gunz0blazin/esp-soil/docs/images/pcb-bottom.png

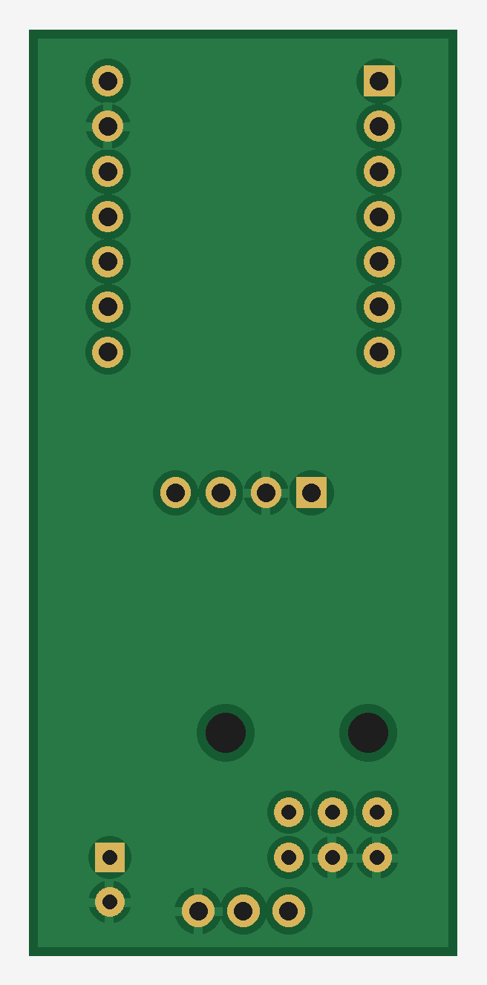
docs/images/pcb-bottom.png
