gunz0blazin/esp-soil/docs/images/pcb-top.png

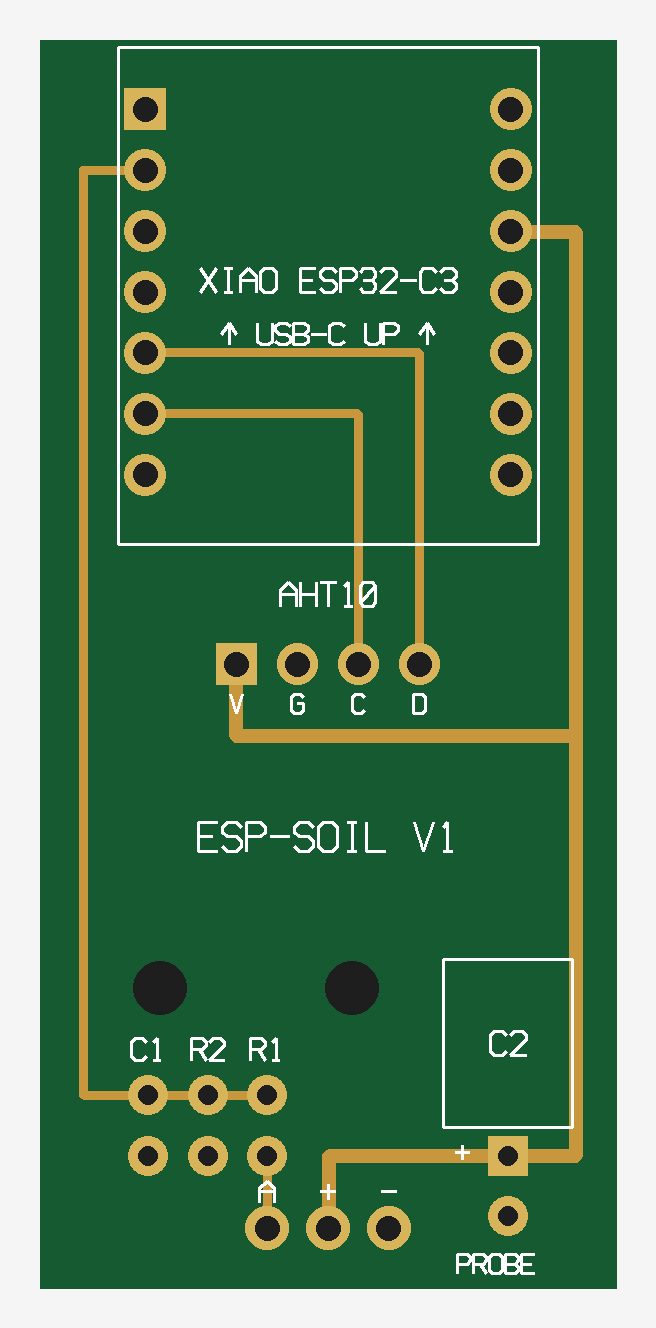
docs/images/pcb-top.png
