gunz0blazin/esp-soil/hardware/kicad/gerbers/preview-v1.1.png

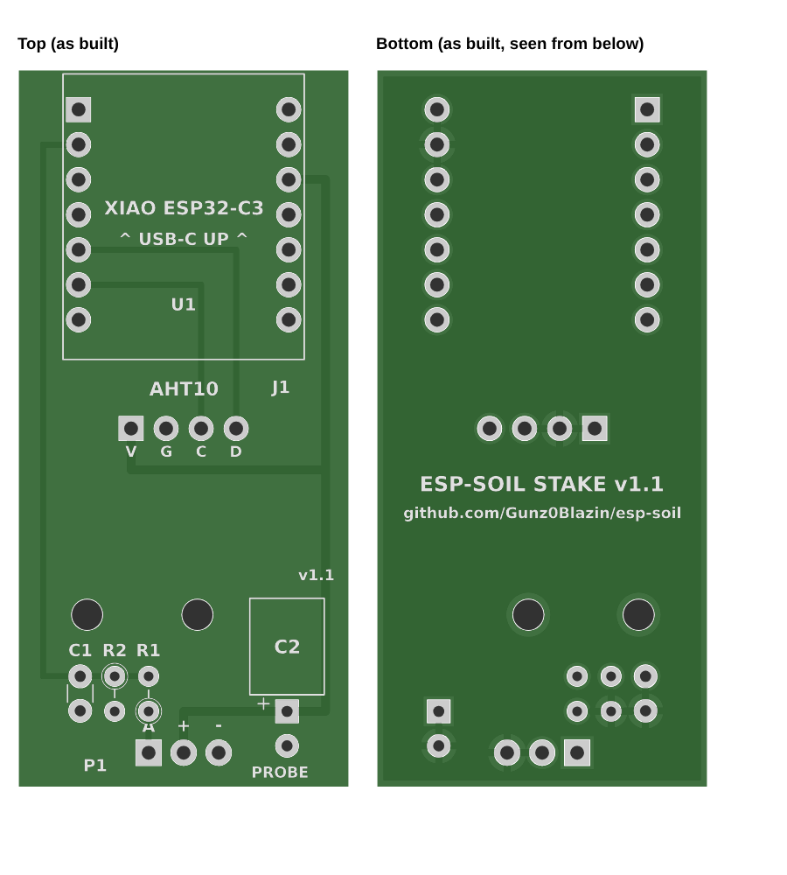
hardware/kicad/gerbers/preview-v1.1.png
