gunz0blazin/esp-soil/hardware/case/stake-case-back.3mf

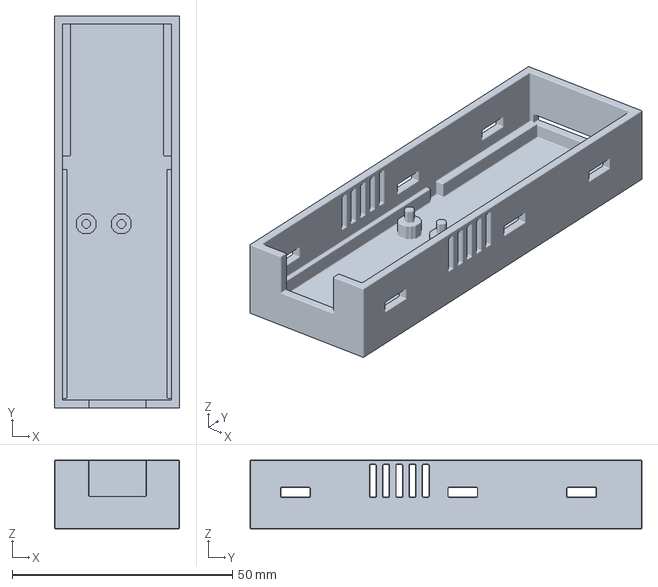
[picture p8: CAD file, 2026-10-12]
hardware/case/stake-case-back.3mf
28.4 x 89.0 x 15.6 mm
