gunz0blazin/esp-soil/hardware/case/stake-case-lid.3mf

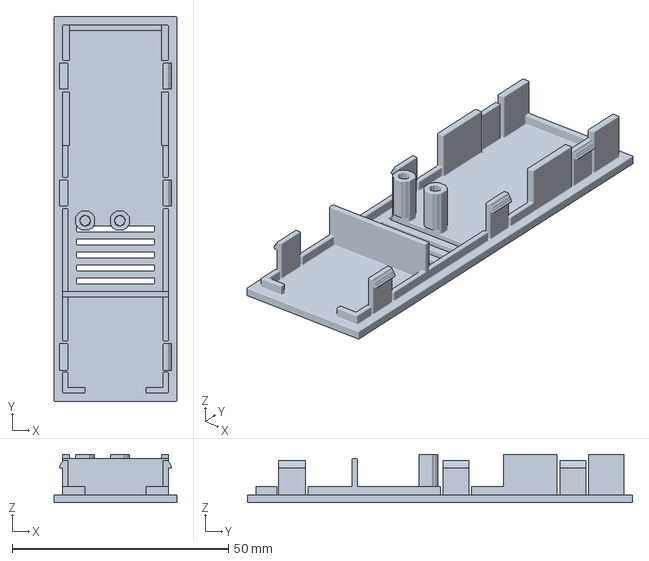
[picture p9: CAD file, 2026-10-12]
hardware/case/stake-case-lid.3mf
28.4 x 89.0 x 11.2 mm
