gunz0blazin/esp-soil/hardware/case/stake-case.scad

// ESP-Soil stake case v2 (snap-fit) - generated by gen_case.py (edit parameters there and re-run)
// Outer: 28.4 x 89.1 x 17.3 mm. part = "back" | "lid" | "both"
part="both";
module back(){
difference(){
difference(){
difference(){
difference(){
difference(){
difference(){
difference(){
difference(){
difference(){
difference(){
difference(){
difference(){
difference(){
difference(){
difference(){
difference(){
difference(){
difference(){
union(){
union(){
union(){
union(){
union(){
union(){
union(){
union(){
difference(){
translate([0.000,0.000,0.000]) cube([28.400,89.100,15.700]);
translate([1.800,1.800,1.600]) cube([24.800,85.500,15.100]);
}
translate([1.800,2.300,1.600]) cube([1.000,52.000,3.000]);
}
translate([25.600,2.300,1.600]) cube([1.000,52.000,3.000]);
}
translate([1.800,57.300,1.600]) cube([1.700,30.000,3.000]);
}
translate([24.900,57.300,1.600]) cube([1.700,30.000,3.000]);
}
translate([7.200,41.800,1.590]) cylinder(d=4.600,h=3.010,$fn=48);
}
translate([7.200,41.800,4.590]) cylinder(d=1.900,h=2.610,$fn=48);
}
translate([15.200,41.800,1.590]) cylinder(d=4.600,h=3.010,$fn=48);
}
translate([15.200,41.800,4.590]) cylinder(d=1.900,h=2.610,$fn=48);
}
translate([7.700,-1.000,7.500]) cube([13.000,2.900,9.200]);
}
translate([2.500,87.200,4.400]) cube([23.400,2.900,2.000]);
}
translate([-1.000,27.300,7.200]) cube([2.900,1.400,7.500]);
}
translate([26.500,27.300,7.200]) cube([2.900,1.400,7.500]);
}
translate([-1.000,30.300,7.200]) cube([2.900,1.400,7.500]);
}
translate([26.500,30.300,7.200]) cube([2.900,1.400,7.500]);
}
translate([-1.000,33.300,7.200]) cube([2.900,1.400,7.500]);
}
translate([26.500,33.300,7.200]) cube([2.900,1.400,7.500]);
}
translate([-1.000,36.300,7.200]) cube([2.900,1.400,7.500]);
}
translate([26.500,36.300,7.200]) cube([2.900,1.400,7.500]);
}
translate([-1.000,39.300,7.200]) cube([2.900,1.400,7.500]);
}
translate([26.500,39.300,7.200]) cube([2.900,1.400,7.500]);
}
translate([-1.000,7.100,7.300]) cube([2.900,6.400,2.200]);
}
translate([26.500,7.100,7.300]) cube([2.900,6.400,2.200]);
}
translate([-1.000,45.100,7.300]) cube([2.900,6.400,2.200]);
}
translate([26.500,45.100,7.300]) cube([2.900,6.400,2.200]);
}
translate([-1.000,72.100,7.300]) cube([2.900,6.400,2.200]);
}
translate([26.500,72.100,7.300]) cube([2.900,6.400,2.200]);
}
}
module lid(){
union(){
union(){
union(){
union(){
union(){
union(){
union(){
union(){
union(){
union(){
union(){
union(){
difference(){
difference(){
difference(){
difference(){
difference(){
difference(){
difference(){
difference(){
difference(){
difference(){
difference(){
union(){
union(){
difference(){
union(){
difference(){
union(){
union(){
union(){
union(){
union(){
union(){
union(){
translate([0.000,0.000,15.700]) cube([28.400,89.100,1.600]);
translate([2.050,2.050,13.700]) cube([1.200,85.000,2.000]);
}
translate([25.150,2.050,13.700]) cube([1.200,85.000,2.000]);
}
translate([2.050,85.850,13.700]) cube([24.300,1.200,2.000]);
}
translate([2.050,2.050,13.700]) cube([5.150,1.200,2.000]);
}
translate([21.200,2.050,13.700]) cube([5.150,1.200,2.000]);
}
translate([2.050,24.300,7.200]) cube([24.300,1.000,8.500]);
}
translate([7.200,41.800,6.200]) cylinder(d=4.600,h=9.500,$fn=48);
}
translate([7.200,41.800,5.200]) cylinder(d=2.400,h=2.600,$fn=48);
}
translate([15.200,41.800,6.200]) cylinder(d=4.600,h=9.500,$fn=48);
}
translate([15.200,41.800,5.200]) cylinder(d=2.400,h=2.600,$fn=48);
}
translate([2.050,59.300,6.300]) cube([1.450,27.750,9.400]);
}
translate([24.900,59.300,6.300]) cube([1.450,27.750,9.400]);
}
translate([5.200,27.300,14.700]) cube([18.000,1.400,3.600]);
}
translate([5.200,30.300,14.700]) cube([18.000,1.400,3.600]);
}
translate([5.200,33.300,14.700]) cube([18.000,1.400,3.600]);
}
translate([5.200,36.300,14.700]) cube([18.000,1.400,3.600]);
}
translate([5.200,39.300,14.700]) cube([18.000,1.400,3.600]);
}
translate([1.950,6.700,5.200]) cube([2.500,7.200,10.490]);
}
translate([23.950,6.700,5.200]) cube([2.500,7.200,10.490]);
}
translate([1.950,44.700,5.200]) cube([2.500,7.200,10.490]);
}
translate([23.950,44.700,5.200]) cube([2.500,7.200,10.490]);
}
translate([1.950,71.700,5.200]) cube([2.500,7.200,10.490]);
}
translate([23.950,71.700,5.200]) cube([2.500,7.200,10.490]);
}
translate([2.050,7.300,7.700]) cube([1.200,6.000,8.000]);
}
multmatrix([[1,0,0,0],[0,0,1,7.300],[0,1,0,0],[0,0,0,1]]) linear_extrude(height=6.000) polygon([[2.050,7.700],[2.050,9.300],[1.250,9.300],[1.250,9.000]]);
}
translate([25.150,7.300,7.700]) cube([1.200,6.000,8.000]);
}
multmatrix([[1,0,0,0],[0,0,1,7.300],[0,1,0,0],[0,0,0,1]]) linear_extrude(height=6.000) polygon([[26.350,7.700],[26.350,9.300],[27.150,9.300],[27.150,9.000]]);
}
translate([2.050,45.300,7.700]) cube([1.200,6.000,8.000]);
}
multmatrix([[1,0,0,0],[0,0,1,45.300],[0,1,0,0],[0,0,0,1]]) linear_extrude(height=6.000) polygon([[2.050,7.700],[2.050,9.300],[1.250,9.300],[1.250,9.000]]);
}
translate([25.150,45.300,7.700]) cube([1.200,6.000,8.000]);
}
multmatrix([[1,0,0,0],[0,0,1,45.300],[0,1,0,0],[0,0,0,1]]) linear_extrude(height=6.000) polygon([[26.350,7.700],[26.350,9.300],[27.150,9.300],[27.150,9.000]]);
}
translate([2.050,72.300,7.700]) cube([1.200,6.000,8.000]);
}
multmatrix([[1,0,0,0],[0,0,1,72.300],[0,1,0,0],[0,0,0,1]]) linear_extrude(height=6.000) polygon([[2.050,7.700],[2.050,9.300],[1.250,9.300],[1.250,9.000]]);
}
translate([25.150,72.300,7.700]) cube([1.200,6.000,8.000]);
}
multmatrix([[1,0,0,0],[0,0,1,72.300],[0,1,0,0],[0,0,0,1]]) linear_extrude(height=6.000) polygon([[26.350,7.700],[26.350,9.300],[27.150,9.300],[27.150,9.000]]);
}
}
if(part=="back") back();
else if(part=="lid") translate([0,0,17.300]) mirror([0,0,1]) lid();
else { back(); translate([0,0,15]) lid(); }
