gunz0blazin/esp-soil/(list of files, cad)

Other CAD files:
hardware/legacy/grow-moisture-case.scad
