gunz0blazin/esp-soil/hardware/kicad/source/verify-pcb-and-fit.png

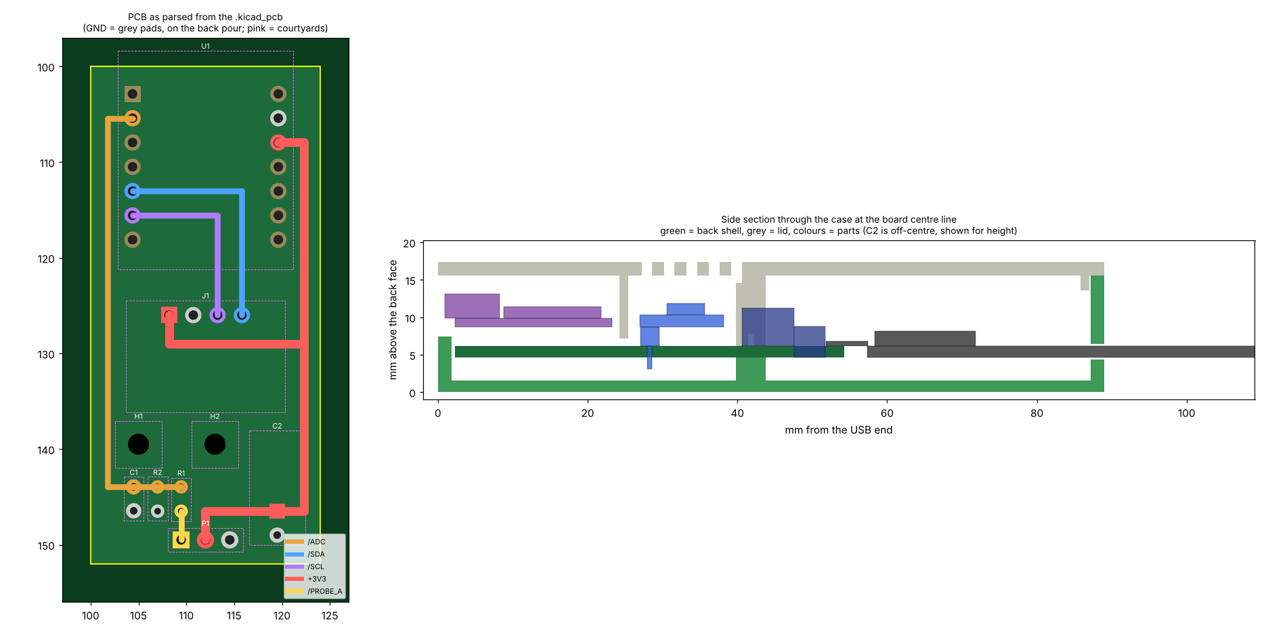
hardware/kicad/source/verify-pcb-and-fit.png
