gunz0blazin/esp-soil/hardware/kicad/esp-soil-stake.kicad_pcb

## KiCad design hardware/kicad/esp-soil-stake.kicad_pcb (2026-10-12)

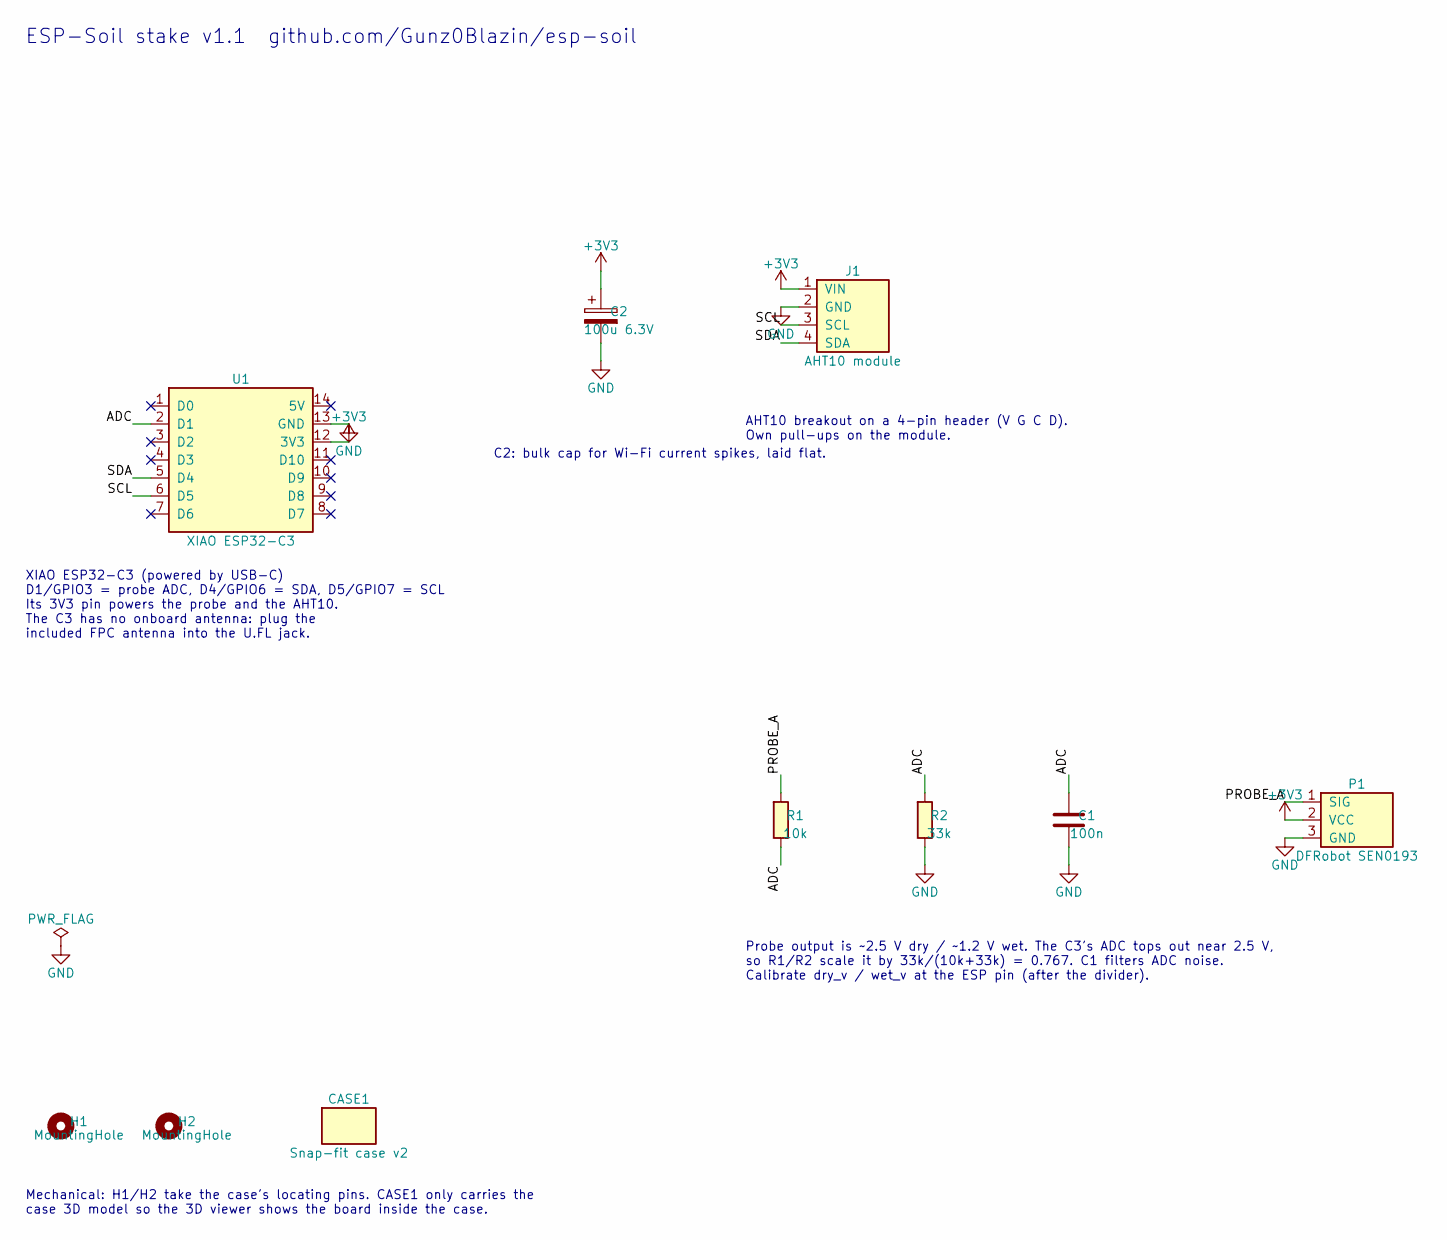
[picture p14: schematic esp-soil-stake.kicad_sch, ESP-Soil stake]

Parts:
C1: 100n; C_Disc_D3.0mm_W1.6mm_P2.50mm
C2: 100u 6.3V; CP_Radial_D5.0mm_P2.50mm_LaidFlat_L7mm
CASE1: Snap-fit case v2; ESP-Soil_Stake_Case_v2
H1, H2: MountingHole; MountingHole_2.2mm_M2
J1: AHT10 module; AHT10_Module_1x04_P2.54mm
P1: DFRobot SEN0193; SEN0193_Wire_Pads_1x03_P2.54mm
R1: 10k; R_Axial_DIN0204_L3.6mm_D1.6mm_P2.54mm_Vertical
R2: 33k; R_Axial_DIN0204_L3.6mm_D1.6mm_P2.54mm_Vertical
U1: XIAO ESP32-C3; XIAO_ESP32C3_THT

Connections:
+3V3: C2.1, J1.1 (VIN), P1.2 (VCC), U1.12 (3V3)
/ADC: C1.1, R1.2, R2.1, U1.2 (D1)
/PROBE_A: P1.1 (SIG), R1.1
/SCL: J1.3 (SCL), U1.6 (D5)
/SDA: J1.4 (SDA), U1.5 (D4)
GND: C1.2, C2.2, J1.2 (GND), P1.3 (GND), R2.2, U1.13 (GND)

Notes on the sheet:
XIAO ESP32-C3 (powered by USB-C) D1/GPIO3 = probe ADC, D4/GPIO6 = SDA, D5/GPIO7 = SCL Its 3V3 pin powers the probe and the AHT10. The C3 has no onboard antenna: plug the included FPC antenna into the U.FL jack.
AHT10 breakout on a 4-pin header (V G C D). Own pull-ups on the module.
Probe output is ~2.5 V dry / ~1.2 V wet. The C3's ADC tops out near 2.5 V, so R1/R2 scale it by 33k/(10k+33k) = 0.767. C1 filters ADC noise. Calibrate dry_v / wet_v at the ESP pin (after the divider).
C2: bulk cap for Wi-Fi current spikes, laid flat.
Mechanical: H1/H2 take the case's locating pins. CASE1 only carries the case 3D model so the 3D viewer shows the board inside the case.
ESP-Soil stake v1.1 github.com/Gunz0Blazin/esp-soil

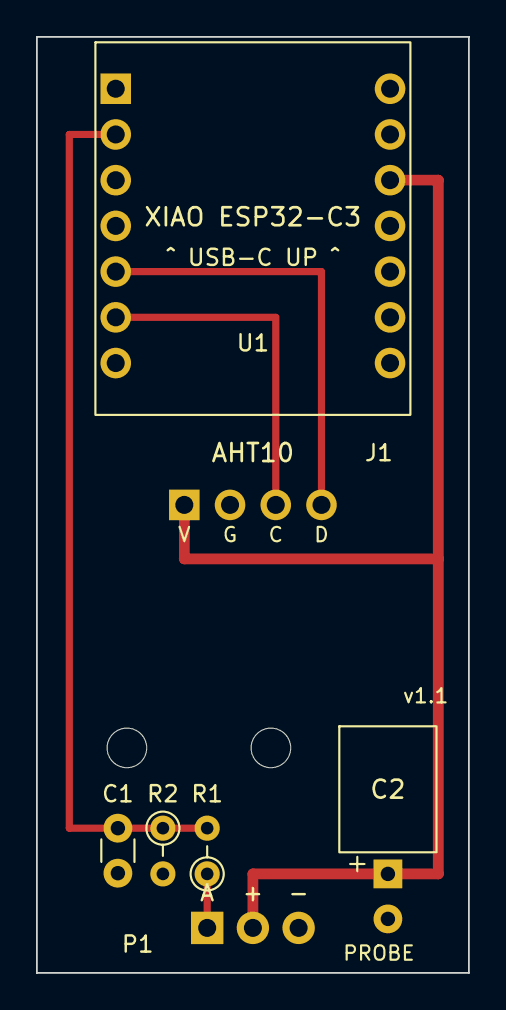
[picture p15: board esp-soil-stake.kicad_pcb from above]

Board: 2 copper layers, 24.0 x 52.0 mm, 10 parts (0 on the bottom side), 6 nets.
