gunz0blazin/esp-soil/(commit log)

2026-10-06 Enhance README with project details and instructions
    Added detailed project description, functionality, parts list, wiring instructions, setup guide, calibration process, VPD explanation, case design, repo layout, and future improvements.
2026-10-06 Revise README for ESP32 setup and remove sections
    Updated instructions for cloning the repository and flashing the ESP32 configuration. Removed case design and to-do list sections.
2026-10-08 Refactor firmware.yaml for moisture monitoring
    Updated configuration for moisture monitoring system, including changes to sensor readings, display settings, and Wi-Fi configuration.
2026-10-12 Restructure repo around the soil stake build
    - README rewritten for the one-stake-per-pot design
    - firmware/: soil-stake.yaml, moisture-test.yaml (with AHT10), moisture-test-probe-only.yaml
    (the uploaded firmware.yaml); original 4-probe config in legacy/ (fixed missing VPD page id)
    - hardware/pcb: Gerbers, build guide, generator scripts
    - hardware/case: snap-fit case as 3MF + OpenSCAD, print notes, generator
    - dashboard/: Prometheus + Grafana compose stack with provisioned dashboard
    (replaces the root docker-compose.yml / prometheus.yml)
    - .gitignore, secrets.example.yaml
    Claude-Session: https://claude.ai/code/session_01HKKZeH8a1iY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
2026-10-12 Add KiCad project for the stake PCB with part 3D models and the case
    - hardware/kicad: schematic, PCB (same routing as v1 Gerbers), project-local
    symbol/footprint libraries, design rules for 2-layer fab
    - XIAO footprint checked against Seeed's OPL KiCad library; passives on
    KiCad stock footprints + 3D models
    - 3D models for XIAO, AHT10 module, SEN0193 probe, laid-flat C2 and the
    snap-fit case (CASE1, 3D only) for fit checks in the 3D viewer
    - source/verify_kicad.py: parse checks, schematic connectivity/ERC,
    schematic-PCB parity, DRC-style clearances, 3D fit against case voxels
    (33 pass, 2 build notes: trim header pins)
    - README updates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
2026-10-12 KiCad README: probe pads, C2 polarity, ground pour
    Claude-Session: https://claude.ai/code/session_01HKKZeH8a1iYM2eLaBgN7eS
2026-10-12 Add v1.1 Gerbers + drills plotted from the KiCad board
    gen_gerbers.py reads esp-soil-stake.kicad_pcb and writes F/B copper (GND
    pour filled with the zone's clearance/thermal settings), masks, silkscreens,
    outline, PTH/NPTH Excellon, and a zip. Cross-checked with gerbonara.
    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
2026-10-12 README: keep to device info, drop personal details
    - Rewrite intro as a plain device description
    - Remove grow-stage VPD table and personal/setup anecdotes
    - Replace home LAN IP with a placeholder in SETUP.md and prometheus.yml
    - License line points to LICENSE
    Claude-Session: https://claude.ai/code/session_01H1o7ttPdKKmLaGabGhFjTJ
2026-10-12 README: document Prometheus + Grafana in depth, with images
    - Data flow diagram, stake /metrics format and sensor update rates
    - Prometheus config, target health, tested PromQL examples, retention
    - Grafana provisioning, panel-by-panel dashboard guide, thresholds,
    auto-discovery, known limitations
    - Remote viewing, security notes, maintenance and troubleshooting
    - Screenshots from a real Prometheus with sample data; dashboard
    preview drawn from the dashboard JSON
    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
